cvanbibber/Bringup-Support/bringupsupport.kicad_pcb

## KiCad design bringupsupport.kicad_pcb (2025-02-17)

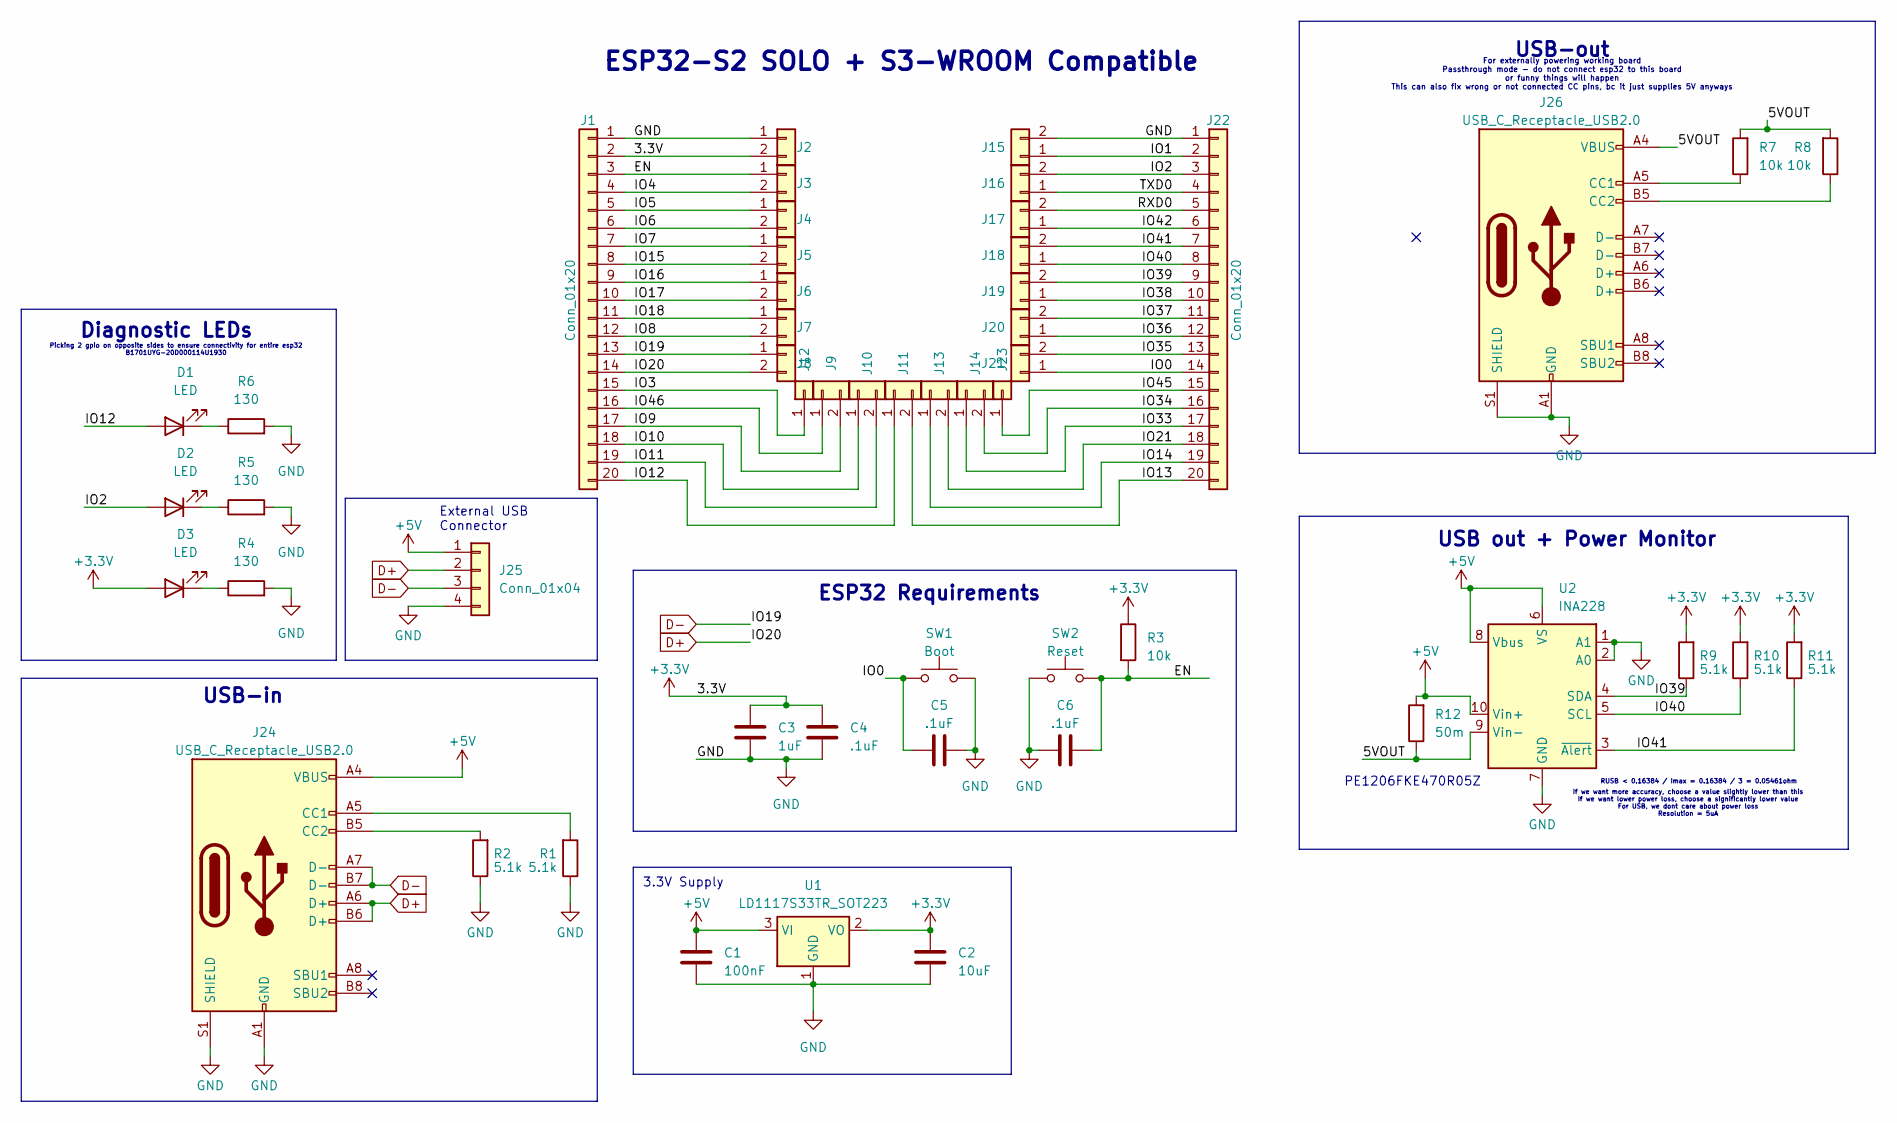
[picture p1: schematic bringupsupport.kicad_sch]

Parts:
C1: 100nF; C_0805_2012Metric_Pad1.18x1.45mm_HandSolder
C2: 10uF; C_0805_2012Metric_Pad1.18x1.45mm_HandSolder
C3: 1uF; C_0805_2012Metric_Pad1.18x1.45mm_HandSolder
C4, C5, C6: .1uF; C_0805_2012Metric_Pad1.18x1.45mm_HandSolder
D1, D2, D3: LED; D_0805_2012Metric_Pad1.15x1.40mm_HandSolder
J1, J22: Conn_01x20; PinHeader_1x20_P2.54mm_Vertical
J2, J3, J4, J5, J6, J7, J8, J9, J10, J11, J13, J14, J15, J16, J17, J18, J19, J20, J21: Conn_01x02; FlexyPin_1x02_P1.27mm
J12, J23: Conn_01x01; FlexyPin_1x01_P1.27mm
J24, J26: USB_C_Receptacle_USB2.0; USB_C_Receptacle_GCT_USB4105-xx-A_16P_TopMnt_Horizontal
J25: Conn_01x04; PinHeader_1x04_P2.54mm_Vertical
R1, R2, R9, R10, R11: 5.1k; R_0805_2012Metric_Pad1.20x1.40mm_HandSolder
R3, R7, R8: 10k; R_0805_2012Metric_Pad1.20x1.40mm_HandSolder
R4, R5, R6: 130; R_0805_2012Metric_Pad1.20x1.40mm_HandSolder
R12: 50m; R_1206_3216Metric_Pad1.30x1.75mm_HandSolder
SW1: Boot; SW_PUSH-12mm
SW2: Reset; SW_PUSH-12mm
U1: LD1117S33TR_SOT223; SOT-223-3_TabPin2
U2: INA228; VSSOP-10_3x3mm_P0.5mm

Connections:
+3.3V: C2.1, C3.1, C4.1, D3.2 (A), J1.2, J2.2, R3.1, R9.2, R10.2, R11.2, U1.2 (VO)
+5V: C1.1, J24.A4 (VBUS), J24.A9 (VBUS), J24.B4 (VBUS), J24.B9 (VBUS), J25.1, R12.2, U1.3 (VI), U2.6 (VS), U2.8 (Vbus), U2.10 (Vin+)
/5VOUT: J26.A4 (VBUS), J26.A9 (VBUS), J26.B4 (VBUS), J26.B9 (VBUS), R7.2, R8.2, R12.1, U2.9 (Vin-)
/EN: C6.2, J1.3, J3.1, R3.2, SW2.2
/IO0: C5.1, J21.1, J22.14, SW1.1
/IO1: J15.1, J22.2
/IO2: D2.2 (A), J16.2, J22.3
/IO3: J1.15, J12.1
/IO4: J1.4, J3.2
/IO5: J1.5, J4.1
/IO6: J1.6, J4.2
/IO7: J1.7, J5.1
/IO8: J1.12, J7.2
/IO9: J1.17, J9.2
/IO10: J1.18, J10.1
/IO11: J1.19, J10.2
/IO12: D1.2 (A), J1.20, J11.1
/IO13: J11.2, J22.20
/IO14: J13.1, J22.19
/IO15: J1.8, J5.2
/IO16: J1.9, J6.1
/IO17: J1.10, J6.2
/IO18: J1.11, J7.1
/IO21: J13.2, J22.18
/IO33: J14.1, J22.17
/IO34: J14.2, J22.16
/IO35: J21.2, J22.13
/IO36: J20.1, J22.12
/IO37: J20.2, J22.11
/IO38: J19.1, J22.10
/IO39: J19.2, J22.9, R9.1, U2.4 (SDA)
/IO40: J18.1, J22.8, R10.1, U2.5 (SCL)
/IO41: J18.2, J22.7, R11.1, U2.3 (~Alert)
/IO42: J17.1, J22.6
/IO45: J22.15, J23.1
/IO46: J1.16, J9.1
/RXD0: J17.2, J22.5
/TXD0: J16.1, J22.4
D+: J1.14, J8.2, J24.A6 (D+), J24.B6 (D+), J25.2
D-: J1.13, J8.1, J24.A7 (D-), J24.B7 (D-), J25.3
GND: C1.2, C2.2, C3.2, C4.2, C5.2, C6.1, J1.1, J2.1, J15.2, J22.1, J24.A1 (GND), J24.A12 (GND), J24.B1 (GND), J24.B12 (GND), J24.S1 (SHIELD), J25.4, J26.A1 (GND), J26.A12 (GND), J26.B1 (GND), J26.B12 (GND), J26.S1 (SHIELD), R1.1, R2.1, R4.2, R5.2, R6.2, SW1.2, SW2.1, U1.1 (GND), U2.1 (A1), U2.2 (A0), U2.7 (GND)
unnamed: D1.1 (K), R6.1
unnamed: D2.1 (K), R5.1
unnamed: D3.1 (K), R4.1
unnamed: J24.A5 (CC1), R1.2
unnamed: J24.B5 (CC2), R2.2
unnamed: J26.A5 (CC1), R7.1
unnamed: J26.B5 (CC2), R8.1

Notes on the sheet:
Picking 2 gpio on opposite sides to ensure connectivity for entire esp32 B1701UYG-20D000114U1930
3.3V Supply
Diagnostic LEDs
PE1206FKE470R05Z
For externally powering working board Passthrough mode - do not connect esp32 to this board or funny things will happen This can also fix wrong or not connected CC pins, bc it just supplies 5V anyways
If we want more accuracy, choose a value slightly lower than this If we want lower power loss, choose a significantly lower value For USB, we dont care about power loss Resolution = 5uA
USB-out
ESP32 Requirements
RUSB < 0.16384 / Imax = 0.16384 / 3 = 0.05461ohm
External USB Connector
USB out + Power Monitor
USB-in
ESP32-S2 SOLO + S3-WROOM Compatible

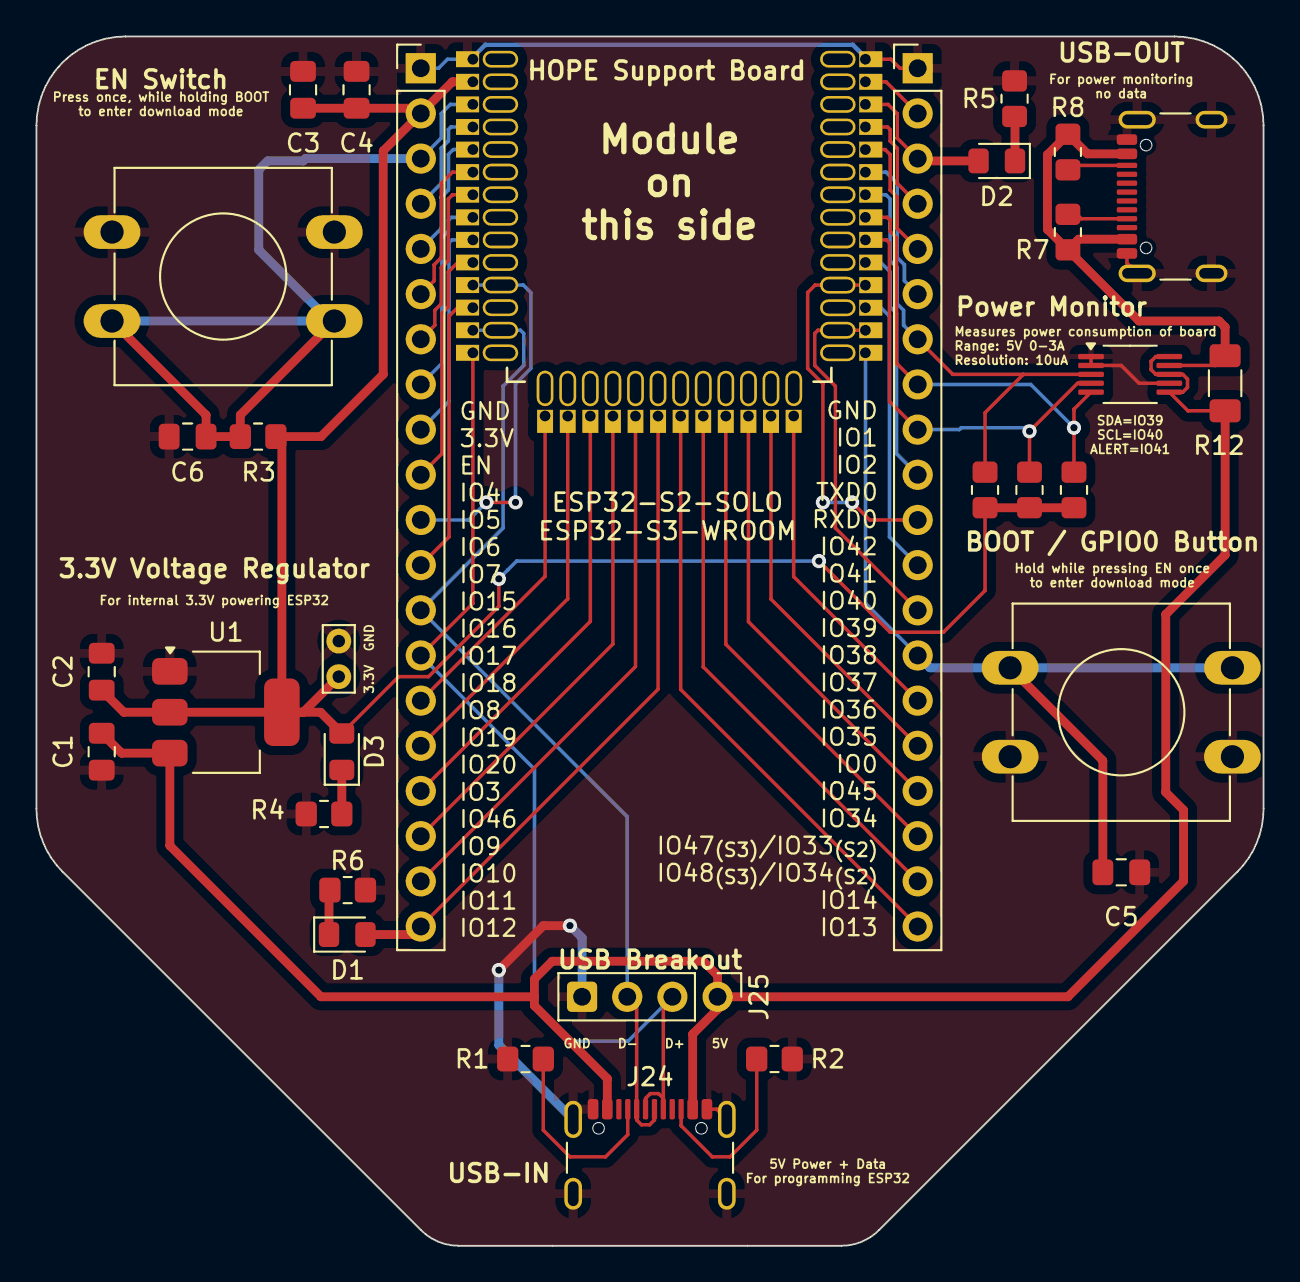
[picture p2: board bringupsupport.kicad_pcb from above]

Board: 2 copper layers, 69.0 x 68.0 mm, 51 parts (0 on the bottom side), 48 nets.
